Jesusm1229/ALU_simplified/(list of files, drawings)

Other design files:
ALU-Definitiva/ALU-DEFINITIVA A ENTREGAR.ms14
ALU-Definitiva/PROTO VIRTUAL FINAL/ALU - PROTO 3D.ms14
